ealang/z-synth-controller/board/schematic.brd

## EAGLE design board/schematic.brd (2021-04-10)

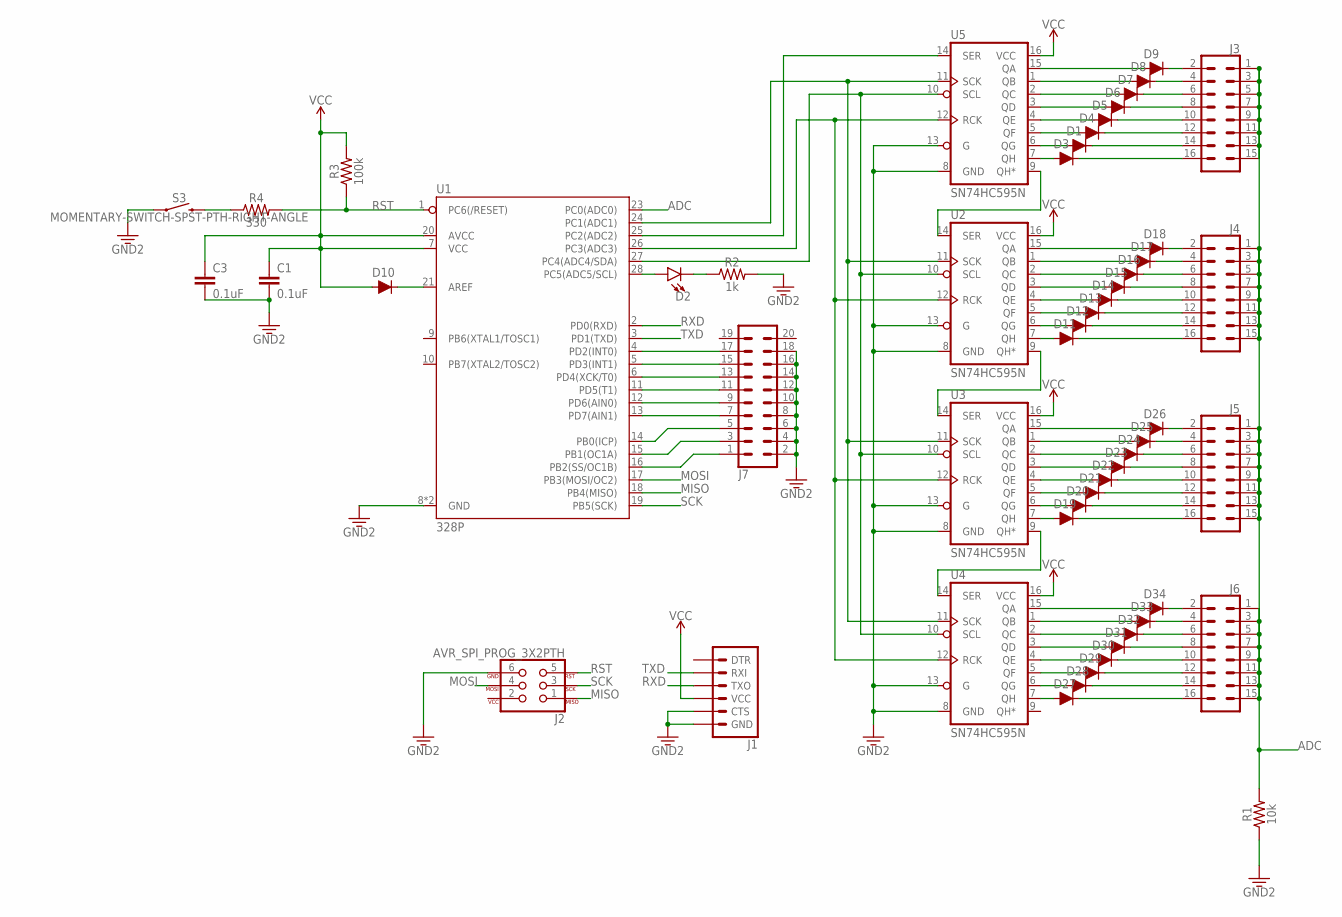
[picture p1: schematic schematic.sch]

Parts:
C1, C3: 0.1uF; CAP-PTH-SMALL-KIT
D1, D3, D4, D5, D6, D7, D8, D9, D10, D11, D12, D13, D14, D15, D16, D17, D18, D19, D20, D21, D22, D23, D24, D25, D26, D27, D28, D29, D30, D31, D32, D33, D34: 200mA/100V/1V; DIODE-1N4148
D2: LED5MM; LED_5MM
J1: 6_PIN_SERIAL_TARGETLOCK; 1X06_LOCK
J2: AVR_SPI_PROG_3X2PTH; 2X3
J3, J4, J5, J6: CONN_08X2_HEADER; 2X8
J7: CONN_10X2; 2X10
R1: 10k; AXIAL-0.3
R2: 1k; AXIAL-0.3
R3: 100k; AXIAL-0.3
R4: 330; AXIAL-0.3
S3: MOMENTARY-SWITCH-SPST-PTH-RIGHT-ANGLE; TACTILE_SWITCH_PTH_RIGHT_ANGLE
U1: 328P; DIP28
U2, U3, U4, U5: SN74HC595N; DIP16

Connections:
ADC: J3.1, J3.3, J3.5, J3.7, J3.9, J3.11, J3.13, J3.15, J4.1, J4.3, J4.5, J4.7, J4.9, J4.11, J4.13, J4.15, J5.1, J5.3, J5.5, J5.7, J5.9, J5.11, J5.13, J5.15, J6.1, J6.3, J6.5, J6.7, J6.9, J6.11, J6.13, J6.15, R1.P$2 (2), U1.23 (PC0(ADC0))
GND: C1.2, C3.2, J1.5 (CTS), J1.6 (GND), J2.6, J7.2, J7.4, J7.6, J7.8, J7.10, J7.12, J7.14, J7.16, J7.18, R1.P$1 (1), R2.P$2 (2), S3.1, U1.8 (GND), U1.22 (GND), U2.8 (GND), U2.13 (G), U3.8 (GND), U3.13 (G), U4.8 (GND), U4.13 (G), U5.8 (GND), U5.13 (G)
MISO: J2.1, U1.18 (PB4(MISO))
MOSI: J2.4, U1.17 (PB3(MOSI/OC2))
unnamed: U1.24 (PC1(ADC1)), U2.11 (SCK), U3.11 (SCK), U4.11 (SCK), U5.11 (SCK)
unnamed: D18.A, U2.15 (QA)
unnamed: U1.25 (PC2(ADC2)), U5.14 (SER)
unnamed: U1.26 (PC3(ADC3)), U2.12 (RCK), U3.12 (RCK), U4.12 (RCK), U5.12 (RCK)
unnamed: U1.27 (PC4(ADC4/SDA)), U2.10 (SCL), U3.10 (SCL), U4.10 (SCL), U5.10 (SCL)
unnamed: D9.C, J3.2
unnamed: D8.A, U5.1 (QB)
unnamed: D8.C, J3.4
unnamed: D9.A, U5.15 (QA)
unnamed: D7.A, U5.2 (QC)
unnamed: D7.C, J3.6
unnamed: D6.A, U5.3 (QD)
unnamed: D6.C, J3.8
unnamed: D5.A, U5.4 (QE)
unnamed: D5.C, J3.10
unnamed: D4.A, U5.5 (QF)
unnamed: D4.C, J3.12
unnamed: D1.A, U5.6 (QG)
unnamed: D1.C, J3.14
unnamed: D3.A, U5.7 (QH)
unnamed: D3.C, J3.16
unnamed: U2.14 (SER), U5.9 (QH*)
unnamed: U2.9 (QH*), U3.14 (SER)
unnamed: U3.9 (QH*), U4.14 (SER)
unnamed: D18.C, J4.2
unnamed: D17.C, J4.4
unnamed: D16.C, J4.6
unnamed: D15.C, J4.8
unnamed: D14.C, J4.10
unnamed: D13.C, J4.12
unnamed: D12.C, J4.14
unnamed: D11.C, J4.16
unnamed: D11.A, U2.7 (QH)
unnamed: D12.A, U2.6 (QG)
unnamed: D13.A, U2.5 (QF)
unnamed: D14.A, U2.4 (QE)
unnamed: D15.A, U2.3 (QD)
unnamed: D16.A, U2.2 (QC)
unnamed: D17.A, U2.1 (QB)
unnamed: D26.A, U3.15 (QA)
unnamed: D19.C, J5.16
unnamed: D20.C, J5.14
unnamed: D25.A, U3.1 (QB)
unnamed: D24.A, U3.2 (QC)
unnamed: D21.C, J5.12
unnamed: D22.C, J5.10
unnamed: D23.A, U3.3 (QD)
unnamed: D22.A, U3.4 (QE)
unnamed: D23.C, J5.8
unnamed: D24.C, J5.6
unnamed: D21.A, U3.5 (QF)
unnamed: D20.A, U3.6 (QG)
unnamed: D25.C, J5.4
unnamed: D26.C, J5.2
unnamed: D19.A, U3.7 (QH)
unnamed: D34.A, U4.15 (QA)
unnamed: D27.C, J6.16
unnamed: D28.C, J6.14
unnamed: D29.C, J6.12
unnamed: D30.C, J6.10
unnamed: D31.C, J6.8
unnamed: D32.C, J6.6
unnamed: D33.C, J6.4
unnamed: D34.C, J6.2
unnamed: D27.A, U4.7 (QH)
unnamed: D28.A, U4.6 (QG)
unnamed: D29.A, U4.5 (QF)
unnamed: D30.A, U4.4 (QE)
unnamed: D31.A, U4.3 (QD)
unnamed: D32.A, U4.2 (QC)
unnamed: D33.A, U4.1 (QB)
unnamed: D10.C, U1.21 (AREF)
unnamed: D2.A, U1.28 (PC5(ADC5/SCL))
unnamed: D2.K (C), R2.P$1 (1)
unnamed: J7.1, U1.16 (PB2(SS/OC1B))
unnamed: J7.3, U1.15 (PB1(OC1A))
unnamed: J7.5, U1.14 (PB0(ICP))
unnamed: J7.7, U1.13 (PD7(AIN1))
unnamed: J7.9, U1.12 (PD6(AIN0))
unnamed: J7.11, U1.11 (PD5(T1))
unnamed: J7.13, U1.6 (PD4(XCK/T0))
unnamed: J7.15, U1.5 (PD3(INT1))
unnamed: J7.17, U1.4 (PD2(INT0))
unnamed: R4.P$1 (1), S3.2
RST: J2.5, R3.P$1 (1), R4.P$2 (2), U1.1 (PC6(/RESET))
RXD: J1.3 (TXO), U1.2 (PD0(RXD))
SCK: J2.3, U1.19 (PB5(SCK))
TXD: J1.2 (RXI), U1.3 (PD1(TXD))
VCC: C1.1, C3.1, D10.A, J1.4 (VCC), R3.P$2 (2), U1.7 (VCC), U1.20 (AVCC), U2.16 (VCC), U3.16 (VCC), U4.16 (VCC), U5.16 (VCC)

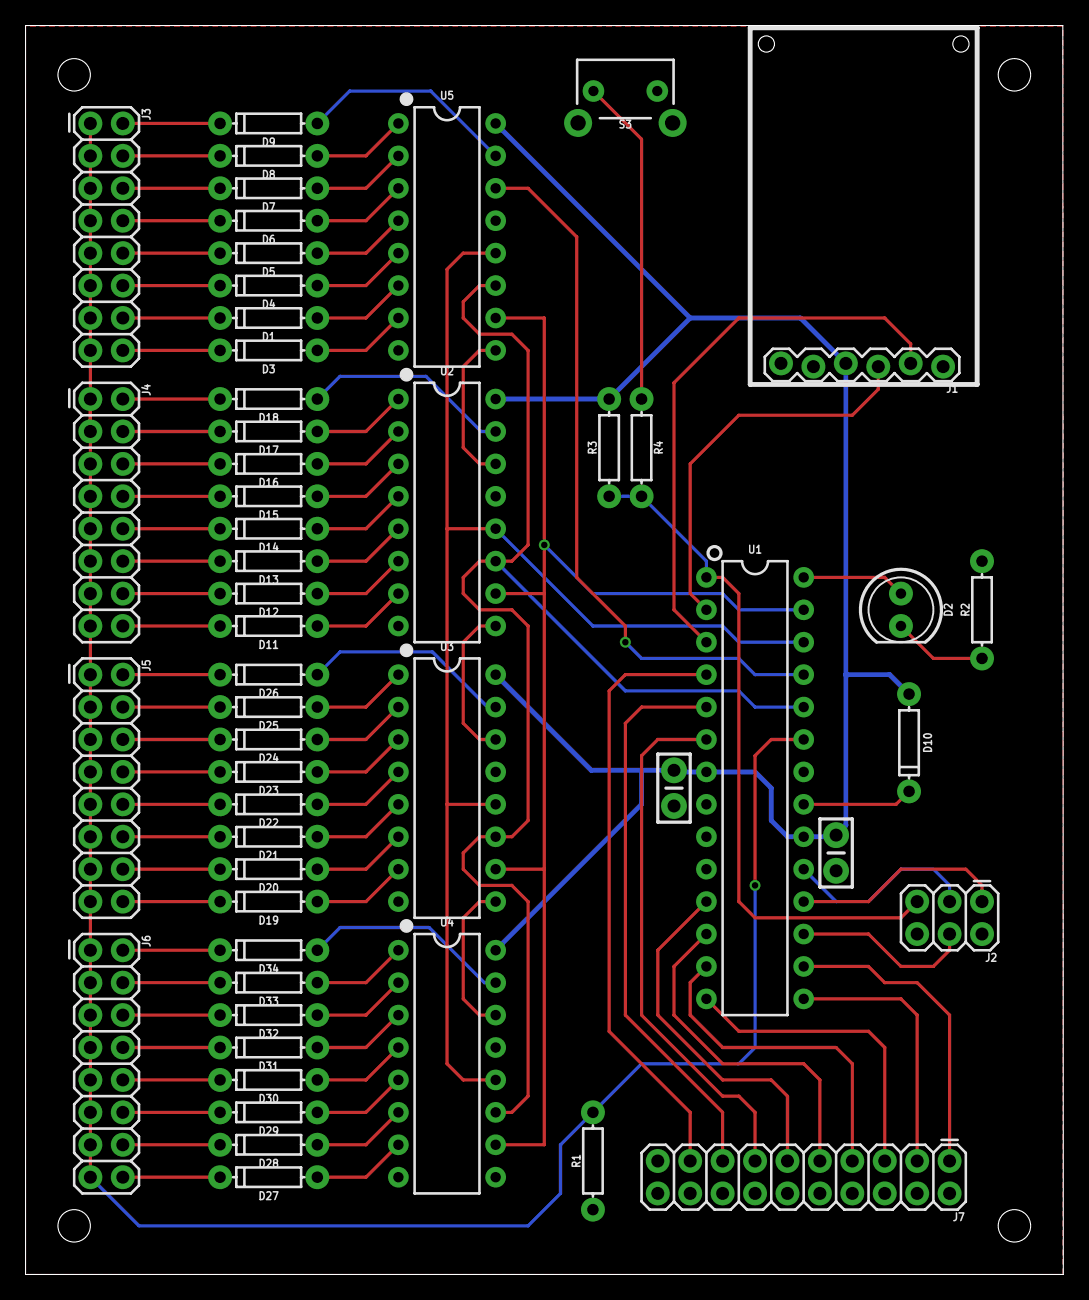
[picture p2: board schematic.brd from above]

Board: 2 copper layers, 81.3 x 97.8 mm, 53 parts (0 on the bottom side), 93 nets.
