ealang/z-synth-controller/(commit log)

2021-03-06 Add select pin
2021-03-06 Implement ADC with select pin via shift reg
2021-03-07 add spi interface to read values
2021-03-14 Wip faceplate
    [faceplate.brd]
2021-03-14 Switch driver to usart
2021-03-14 Add dimmable led
2021-03-16 Refactor adc change poll api
2021-03-19 Rename button input update function for consistency
2021-03-19 Add led sequences
2021-03-21 Basic noise filtering
2021-03-21 Starting point driver
2021-03-21 Add rolling average to reduce noise
    [adc_poll.c, adc_poll.h, rolling_avg.c, rolling_avg.h]
2021-03-22 Avoid ramp up at start
    [rolling_avg.c, rolling_avg.h]
2021-03-22 Add fuse settings
2021-03-22 Avoid sending redundant nrpn messages
    [midi_delivery.py]
2021-03-27 Add eagle project
    [schematic.brd, schematic.sch]
2021-03-28 Switch to 8 bit adc mode
2021-03-28 Increase to 32 sensors
2021-03-28 Account for pot tolerances, map to linear range
    [param_mapping.py]
2021-03-28 Cleanup schematic
    [schematic.sch]
2021-04-06 Mapping options for n position switch
2021-04-10 Fix crossed rx/tx
    [schematic.brd, schematic.sch]
2021-04-12 Add calibration config util
2021-10-27 Separate ADC calibration config for easier update
2023-02-07 Wire lfo param select
